Diiliev/E_Bike_Memory_Seat/(commit log)

2021-09-03 Added function to read messages from CAN bus and modified the workflow.
2022-02-09 Add overshoot protection to microcontroller. Fix bugs in microcontroller. Fix bugs in ROS server. Change web client info and values from 10 to 140mm. Improve documentation. Add datasheets. Fix errors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
    [EbmsMicrocontroller.ino]
